Chunghyon/bems_rtu/schematic/RTU_AI_PLATFORM_ESP32_261003.BOM.xlsx

Smart RTU Revised: Friday, October 02, 2026
20260928 Revision: 0.1
 |  |  | 생산대수 |  | 10
Bill Of Materials October 5,2026 3:11:56 | Page1
Item | Quantity | Reference | Part | 규격 | 필요수량 | 비고 | 하나재고번호
______________________________________________
1 | 1 | BD1 | CIM21J601NE/NC | 미삽
2 | 1 | BD2 | CIM21J601NE | 1608,80옴,700mA | 10 | 비드 일반
3 | 1 | B1 | BLM18EG331TN1 | 1608,80옴,700mA | 10 | 비드 일반
4 | 1 | B2 | FB0805/600R/2A | 2012,600옴,0.5A | 10 | Mouser
5 | 2 | CE1,CE3 | 22uF/3216 | 3216 | 20 | Mouser
6 | 3 | CE2,CE5,CE9 | 100uF/10V/6.3mm | SMD전해 6.3pi, 16V | 30 | 랙 커패시터 박스
7 | 2 | CE4,CE8 | 470uF/10V/6.3mm | SMD전해 6.3pi, 16V | 20 | 랙 커패시터 박스
8 | 1 | CE6 | 220uF/50V/8pi | SMD전해 8pi, 16V | 10 | 랙 커패시터 박스
9 | 2 | CE7,CE10 | 470uF/25V | SMD전해 8pi, 16V | 20 | 랙 커패시터 박스
10 | 6 | C1,C5,C8,C10,C11,C13 | 105 | 1608 | 60 | 캡 부품통
11 | 20 | C2,C9,C16,C18,C22,C24, | 104 | 1608 | 200 | 캡 부품통
 |  | C39,C41,C42,C43,C44,C45,
 |  | C46,C54,C66,C72,C80,C81,
 |  | C82,C83
12 | 5 | C3,C17,C65,C71,C77 | 106/2012 | 2012 | 50 | 캡 부품통
13 | 2 | C4,C7 | 106/1608 | 1608 | 20 | 캡 부품통
14 | 3 | C6,C35,C38 | 106 | 1608 | 30 | 캡 부품통
15 | 6 | C14,C15,C50,C52,C61,C73 | 10u | 2012 | 60 | 캡 부품통
16 | 14 | C19,C20,C21,C23,C27,C28, | 103 | 1608 | 140 | 캡 부품통
 |  | C29,C30,C31,C32,C33,C37,
 |  | C68,C75
17 | 4 | C25,C26,C34,C36 | 224 | 1608 | 40 | 캡 부품통
18 | 3 | C40,C49,C64 | 104/100V/2012 | 2012 | 30 | 캡 부품통
19 | 1 | C47 | 1u/50V | 2012 | 10 | 캡 부품통
20 | 2 | C48,C62 | 1n | 1608 | 20 | 캡 부품통
21 | 8 | C51,C53,C57,C59,C70,C74, | 100n | 1608 | 80 | 캡 부품통
 |  | C78,C79
22 | 2 | C55,C56 | 6.8nF | 1608 | 20 | 캡 부품통
23 | 2 | C58,C67 | 18pF | 1608 | 20 | 캡 부품통
24 | 2 | C60,C69 | 104/1608 | 1608 | 20 | 캡 부품통
25 | 1 | C63 | 22n | 1608 | 10 | 캡 부품통
26 | 1 | C76 | 12p | 1608 | 10 | 캡 부품통
27 | 1 | DN1 | PESD2USB5UV-TR |  | 10 | 작업대 위 부품 박스
28 | 16 | D1,D2,D3,D4,D5,D6,D10, | LL4148 |  | 160 | 작업대 아래 SMD 부품통
 |  | D11,D16,D17,D23,D24,D37,
 |  | D38,D39,D41
29 | 1 | D7 | SS16 |  | 10 | Mouser
30 | 1 | D8 | GREEN | 1608 | 10 | 작업대 아래 SMD 부품통
31 | 1 | D9 | RED | 1608 | 10 | 작업대 아래 SMD 부품통
32 | 16 | D12,D13,D14,D15,D18,D19, | GG040205170N2P | 1608 | 160 | mouser
 |  | D20,D21,D22,D25,D26,D27,
 |  | D28,D29,D30,D31
33 | 1 | D32 | BZT52-B15J |  | 10 | Mouser
34 | 1 | D33 | MMSZ5255 | SOT-23-5 | 10 | Mouser
35 | 3 | D34,D35,D36 | B2100A-13-F |  | 30 | Mouser
36 | 12 | F1,F2,F3,F4,F5,F6,F7,F8, | SMDH0805B010TF |  | 120 | mouser
 |  | F9,F10,F11,F12
37 | 2 | IC1,IC2 | ADS131M08 |  | 20 | mouser
38 | 1 | IC3 | 1117-1.8 |  | 10 | 작업대 위 부품 박스
39 | 1 | IC4 | 1117-3.3 |  | 10 | 작업대 위 부품 박스
40 | 1 | J1 | USB_TYPE-C |  | 10 | 작업대 아래 박스
41 | 2 | J2,J5 | ECH350V/6P |  | 20 | 디바이스마트
42 | 3 | J3,J4,J7 | 2.54mm/Header |  | 30 | 작업대 아래 부품 박스
43 | 1 | J6 | 2.54mm |  | 10 | 작업대 아래 부품 박스
44 | 1 | J8 | ECH350V/8P |  | 10 | 디바이스마트
45 | 1 | J9 | SMW250-02 |  | 10 | 디바이스마트
46 | 2 | J11,J12 | ECH350V/2P |  | 20 | 디바이스마트
47 | 1 | J13 | ECH350V/4P |  | 10 | 디바이스마트
48 | 1 | L1 | FCM1608KF-800T07 |  | 10 | 작업대 아래 SMD 부품통
49 | 1 | L2 | NRS4018T2R2 |  | 10 | 작업대 위 부품 박스
50 | 1 | L3 | SLS5D28S330MTT(SWPA6020S3R3MT) | NRS6020T3R3NMGJ | 10 | 디바이스마트
51 | 16 | Q1,Q2,Q3,Q4,Q7,Q8,Q10, | MMBT3904 |  | 160 | Mouser
 |  | Q11,Q12,Q13,Q14,Q15,Q17,
 |  | Q18,Q19,Q21
52 | 2 | Q5,Q6 | BC817-40 |  | 20 | 작업대 위 부품 박스
53 | 1 | Q16 | DMN10H220L-7 |  | 10 | Mouser
54 | 3 | RV1,RV2,RV3 | 391KD07 |  | 30 | Mouser
55 | 16 | R1,R2,R10,R11,R22,R23, | 470 | 1608 | 160 | SMD 부품통
 |  | R86,R87,R106,R110,R123,
 |  | R126,R176,R177,R178,R180
56 | 3 | R3,R52,R62 | 4.7k | 1608 | 30 | SMD 부품통
57 | 12 | R4,R6,R12,R14,R19,R21, | 5k/2012/0.1% |  | 120 | Mouser
 |  | R26,R28,R30,R32,R40,R42
58 | 12 | R5,R7,R13,R15,R20,R24, | 10k/2012/0.1% |  | 120 | Mouser
 |  | R27,R29,R31,R33,R41,R43
59 | 2 | R8,R16 | 5.1k | 1608 | 20 | SMD 부품통
60 | 1 | R9 | 1.5k | 1608 | 10 | SMD 부품통
61 | 16 | R17,R25,R38,R54,R136, | 10k | 1608 | 160 | SMD 부품통
 |  | R143,R144,R145,R147,R150,
 |  | R151,R152,R153,R154,R155,
 |  | R164
62 | 3 | R18,R139,R160 | 1M | 1608 | 30 | SMD 부품통
63 | 18 | R34,R35,R95,R101,R105, | 1k | 1608 | 180 | SMD 부품통
 |  | R111,R116,R118,R120,R125,
 |  | R132,R133,R134,R135,R166,
 |  | R170,R171,R175
64 | 2 | R45,R140 | 10 | 1608 | 20 | SMD 부품통
65 | 6 | R46,R47,R48,R49,R50,R51 | 10/3216 | 3216 | 60 | mouser
66 | 18 | R53,R55,R56,R58,R59,R60, | 100k/3216 | 3216 | 180 | mouser
 |  | R61,R63,R64,R66,R67,R68,
 |  | R69,R70,R71,R73,R74,R75
67 | 3 | R57,R65,R72 | 1k/3216 | 3216 | 30 | mouser
68 | 24 | R76,R77,R78,R79,R80,R81, | 49.9k/2012 | 2012 | 240 | Mouser
 |  | R82,R83,R84,R85,R88,R89,
 |  | R90,R91,R92,R93,R96,R97,
 |  | R102,R103,R108,R109,R112,
 |  | R113
69 | 12 | R94,R98,R100,R107,R114, | 1k/2012 | 2012 | 120 | mouser
 |  | R115,R117,R122,R124,R127,
 |  | R128,R129
70 | 6 | R99,R104,R119,R121,R130, | 49.9/3216 | 3216 | 60 | mouser
 |  | R131
71 | 1 | R137 | 51k | 1608 | 10 | SMD 부품통
72 | 1 | R138 | 24.9k | 1608 | 10 | SMD 부품통
73 | 4 | R141,R142,R158,R159 | 50 | 1608 | 40 | SMD 부품통
74 | 1 | R146 | 100k | 1608 | 10 | SMD 부품통
75 | 1 | R148 | 450k | 1608 | 10 | SMD 부품통
76 | 2 | R149,R157 | 330 | 1608 | 20 | SMD 부품통
77 | 1 | R156 | 5.1 | 1608 | 10 | SMD 부품통
78 | 1 | R161 | 33m/2012 | 2012 | 10 | Mouser
79 | 1 | R162 | 12.4k/1% | 1608 | 10 | SMD 부품통
80 | 1 | R163 | 57k | 1608 | 10 | SMD 부품통
81 | 1 | R165 | 580k | 1608 | 10 | SMD 부품통
82 | 2 | R167,R172 | 150 | 1608 | 20 | SMD 부품통
83 | 2 | R168,R173 | 120 | 1608 | 20 | SMD 부품통
84 | 2 | R169,R174 | 75 | 1608 | 20 | SMD 부품통
85 | 4 | R181,R182,R183,R184 | 750/3216 | 3216 | 40 | Mouser
86 | 2 | R185,R186 | NC | 미삽
87 | 1 | SW1 | SMD TACT |  | 10 | 작업대 위 부품 박스
88 | 1 | SW2 | SW_DIP-6/SM |  | 10 | 디바이스마트
89 | 2 | SW6,SW7 | KDS-03H |  | 20 | 디바이스마트
90 | 4 | S1,S2,S3,S4 | HOLE | 미삽
91 | 6 | U1,U5,U9,U12,U13,U15 | TLV9062/SOIC-8 |  | 60 | mouser
92 | 16 | U2,U3,U7,U8,U10,U11,U20, | IM03GR |  | 160 | 알리익스프레스 봉투
 |  | U21,U22,U23,U24,U25,U36,
 |  | U37,U38,U40
93 | 1 | U4 | PCA9555PWR |  | 10 | 작업대 아래 박스
94 | 1 | U6 | CH340K |  | 10 | 작업대 옆 공구통 위
95 | 1 | U16 | ESPS3-WROOM-1-N16R8 |  | 10 | 알리익스프레스 봉투
96 | 3 | U17,U18,U19 | ZMPT101B | 트랜스, 중국 | 30 | 알리익스프레스 봉투
97 | 2 | U26,U28 | LMB110S |  | 20 | 하나전자
98 | 1 | U27 | AP3417C |  | 10 | 작업대 아래 박스
99 | 1 | U29 | LPJ1153GHNL |  | 10 | 작업대 뒤쪽 부품 박스
100 | 2 | U30,U33 | 78M05-DPAK3 |  | 20 | 작업대 위 부품 박스
101 | 1 | U31 | W5500-QFP48 |  | 10 | 작업대 아래 박스
102 | 1 | U32 | TX4138 |  | 10 | 하나전자
103 | 2 | U34,U35 | MAX485 |  | 20 | 하나전자
104 | 4 | U41,U42,U43,U44 | H11L1 |  | 40 | Mouser
105 | 1 | X1 | 25Mhz(3225_XTAL) | 3225, 30ppm | 10 | Mouser
106 | 1 | Y1 | 8.192Mhz, OSC | 3225, 30ppm | 10 | Mouser
