Chunghyon/bems_rtu/schematic/sch_rtu_261027.pdf

## Activity LED

## I/O Expander

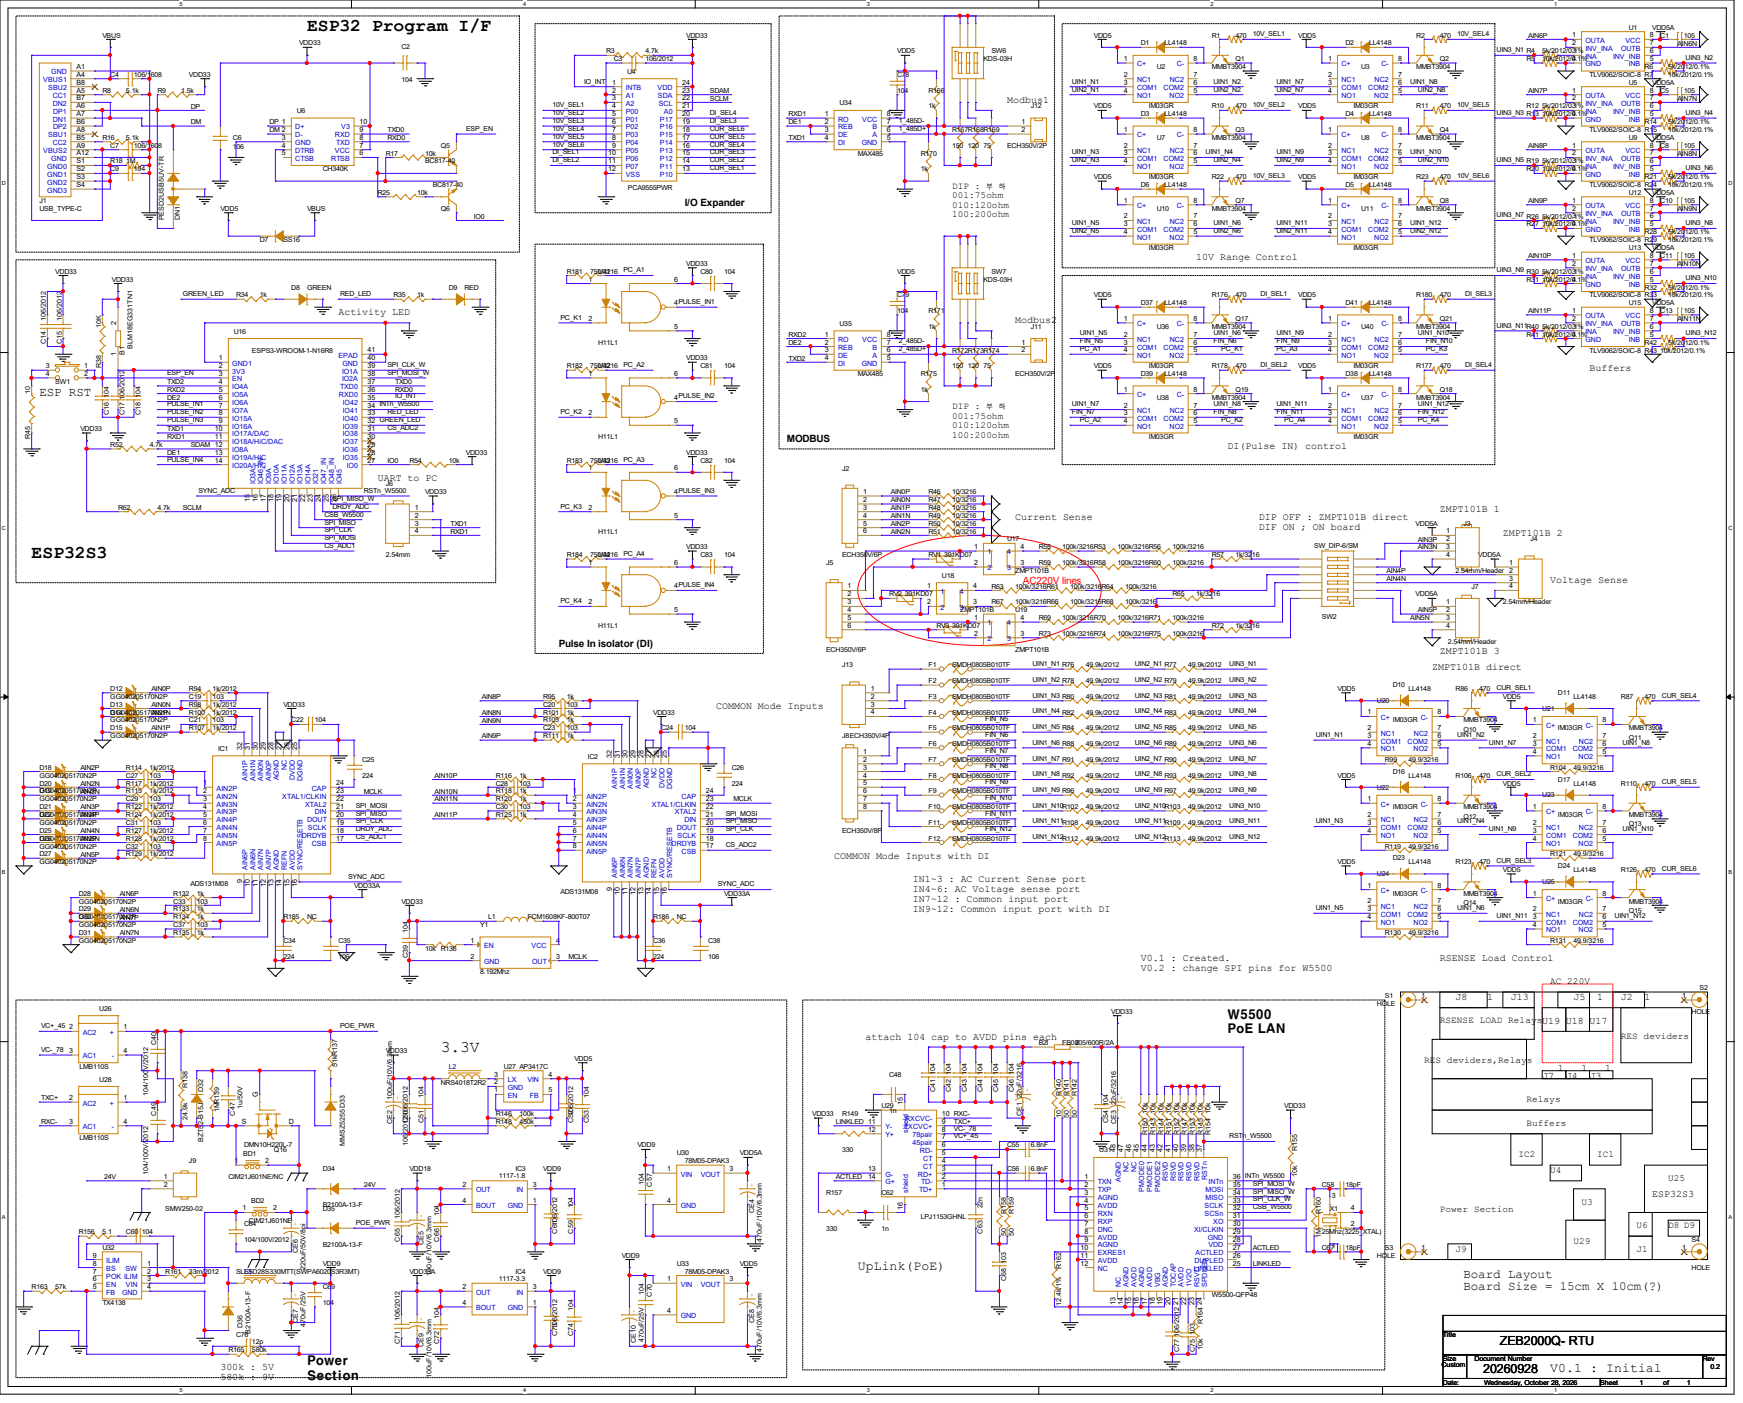
[picture p1: page 1]

U34 MAX485 RO
1 REB
24 DGND ²⁵ DVDD ²⁶ NC ²⁷ AGND ²⁸ AIN⁰P ²⁹ AIN⁰N ³⁰ AIN¹N ³¹ AIN¹P ³² Q5 BC817-40

DI(Pulse IN) control

DIP OFF : ZMPT101B direct
DIF ON ; ON board

Pulse In isolator (DI)

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

9 AIN6N 10 AIN7N 11 AIN7P 12 AGND 13 REFN 14 AVDD 15 SYNC/RESETB 16 CSB DRDYB 17

COMMON Mode Inputs with DI

IN1~3 : AC Current Sense port
IN4~6: AC Voltage sense port
IN7~12 : Common input port
IN9~12: Common input port with DI

V0.1 : Created.
V0.2 : change SPI pins for W5500

VC-_78 VC+_45 RXC- TXC+
