Chunghyon/bems_rtu/(list of files, drawings)

Other design files:
schematic/RTU_AI_PLATFORM_ESP32_261003.DSN
schematic/RTU_AI_PLATFORM_ESP32_261027.DSN
