Chunghyon/bems_rtu/main/eth_w5500.c

#include "project.h"
#include "board.h"
#include "eth_w5500.h"
#include "esp_log.h"
#include "esp_check.h"
#include "esp_mac.h"
#include "driver/gpio.h"
#include "driver/spi_master.h"
#include "esp_rom_sys.h"

#define SPI_ETHERNETS_NUM           1

typedef struct {
    uint8_t spi_cs_gpio;
    int8_t int_gpio;
    uint32_t polling_ms;
    int8_t phy_reset_gpio;
    uint8_t phy_addr;
    uint8_t *mac_addr;
}spi_eth_module_config_t;

static const char *TAG = "w5500_init";

static bool gpio_isr_svc_init_by_eth = false; // indicates that we initialized the GPIO ISR service

// Forward declaration — defined later in this file
static esp_eth_handle_t eth_init_spi(spi_eth_module_config_t *spi_eth_module_config, esp_eth_mac_t **mac_out, esp_eth_phy_t **phy_out);

esp_err_t w5500_reinstall_driver(esp_eth_handle_t *eth_handle_io)
{
    if (!eth_handle_io || !*eth_handle_io) return ESP_ERR_INVALID_ARG;

    esp_eth_handle_t old = *eth_handle_io;
    ESP_LOGI(TAG, "W5500 full driver reinstall requested");

    // Best-effort stop (may fail if state already inconsistent)
    esp_err_t err = esp_eth_stop(old);
    if (err != ESP_OK) {
        ESP_LOGW(TAG, "esp_eth_stop returned %s (continuing with reinstall)", esp_err_to_name(err));
    }
    vTaskDelay(pdMS_TO_TICKS(20));

    esp_eth_mac_t *mac = NULL;
    esp_eth_phy_t *phy = NULL;
    esp_eth_get_mac_instance(old, &mac);
    esp_eth_get_phy_instance(old, &phy);

    err = esp_eth_driver_uninstall(old);
    if (err != ESP_OK) {
        ESP_LOGE(TAG, "driver uninstall failed: %s", esp_err_to_name(err));
        return err;
    }
    if (mac) mac->del(mac);
    if (phy) phy->del(phy);
    *eth_handle_io = NULL;

    // Hardware reset of the chip
    gpio_set_level(ETH_RST_PIN, 0);
    vTaskDelay(pdMS_TO_TICKS(20));
    gpio_set_level(ETH_RST_PIN, 1);
    vTaskDelay(pdMS_TO_TICKS(100));
    ESP_LOGI(TAG, "W5500 RST pin pulsed");

    // Rebuild SPI Ethernet module config and reinstall driver
    spi_eth_module_config_t cfg = { 0 };
    cfg.spi_cs_gpio = ETH_SPI_CS;
    cfg.int_gpio = ETH_INT_PIN;
    cfg.polling_ms = 0;
    cfg.phy_reset_gpio = ETH_RST_PIN;
    cfg.phy_addr = 1;

    uint8_t base_mac[ETH_ADDR_LEN];
    uint8_t local_mac[ETH_ADDR_LEN];
    if (esp_efuse_mac_get_default(base_mac) == ESP_OK) {
        esp_derive_local_mac(local_mac, base_mac);
        cfg.mac_addr = local_mac;
    }

    esp_eth_handle_t neu = eth_init_spi(&cfg, NULL, NULL);
    if (!neu) {
        ESP_LOGE(TAG, "driver reinstall failed");
        return ESP_FAIL;
    }

    *eth_handle_io = neu;
    ESP_LOGI(TAG, "W5500 driver reinstalled");
    return ESP_OK;
}

esp_err_t w5500_hard_reset_and_start(esp_eth_handle_t eth_handle)
{
    if (!eth_handle) return ESP_ERR_INVALID_ARG;

    ESP_LOGI(TAG, "W5500 hardware reset requested");

    esp_err_t err = esp_eth_stop(eth_handle);
    if (err != ESP_OK) {
        ESP_LOGW(TAG, "esp_eth_stop returned %s (continuing)", esp_err_to_name(err));
    }

    vTaskDelay(pdMS_TO_TICKS(20));

    // RST pin pulse (do this even if stop failed — chip needs a known state)
    gpio_set_level(ETH_RST_PIN, 0);
    vTaskDelay(pdMS_TO_TICKS(20));
    gpio_set_level(ETH_RST_PIN, 1);
    vTaskDelay(pdMS_TO_TICKS(150));   // longer settle after hard reset
    ESP_LOGI(TAG, "W5500 RST pin pulsed");

    // Do not touch PHYCFGR — RST bit is active-low (0=reset, 1=normal).
    // Driver will configure auto-negotiation on esp_eth_start().

    err = esp_eth_start(eth_handle);
    if (err != ESP_OK) {
        ESP_LOGE(TAG, "esp_eth_start after hard reset failed: %s", esp_err_to_name(err));
        ESP_LOGE(TAG, "Driver internal state may be inconsistent. Power-cycle recommended.");
        return err;
    }

    ESP_LOGI(TAG, "W5500 hardware reset + re-init done");
    return ESP_OK;
}

static void w5500_hard_reset(void)
{
    gpio_set_level(ETH_RST_PIN, 0);
    vTaskDelay(pdMS_TO_TICKS(10));
    gpio_set_level(ETH_RST_PIN, 1);
    vTaskDelay(pdMS_TO_TICKS(50));
    ESP_LOGI(TAG, "W5500 hard reset done");
}

/**
 * @brief SPI bus initialization (to be used by Ethernet SPI modules)
 *
 * @return
 *          - ESP_OK on success
 */
static esp_err_t spi_bus_init(void)
{
    esp_err_t ret = ESP_OK;

#ifdef ETH_INT_PIN
    gpio_isr_svc_init_by_eth = true;
#endif

#if PP_ETH_USE_SPI3
    // Dedicated SPI3 bus for W5500
    spi_bus_config_t eth_buscfg = {
        .mosi_io_num = ETH_SPI_MOSI,
        .miso_io_num = ETH_SPI_MISO,
        .sclk_io_num = ETH_SPI_CLK,
        .quadwp_io_num = -1,
        .quadhd_io_num = -1,
    };
    ESP_ERROR_CHECK(spi_bus_initialize(ETH_SPI_HOST, &eth_buscfg, SPI_DMA_CH_AUTO));
    ESP_LOGI(TAG, "ETH SPI bus ready (SPI3_HOST, MOSI=%d MISO=%d CLK=%d)",
             ETH_SPI_MOSI, ETH_SPI_MISO, ETH_SPI_CLK);
#else
    ESP_LOGI(TAG, "ETH shares SPI2_HOST with ADCs");
#endif

    return ret;
}

/**
 * @brief Ethernet SPI modules initialization
 *
 * @param[in] spi_eth_module_config specific SPI Ethernet module configuration
 * @param[out] mac_out optionally returns Ethernet MAC object
 * @param[out] phy_out optionally returns Ethernet PHY object
 * @return
 *          - esp_eth_handle_t if init succeeded
 *          - NULL if init failed
 */
static esp_eth_handle_t eth_init_spi(spi_eth_module_config_t *spi_eth_module_config, esp_eth_mac_t **mac_out, esp_eth_phy_t **phy_out)
{
    esp_eth_handle_t ret = NULL;

    // Init common MAC and PHY configs to default
    eth_mac_config_t mac_config = ETH_MAC_DEFAULT_CONFIG();
    eth_phy_config_t phy_config = ETH_PHY_DEFAULT_CONFIG();

    // Update PHY config based on board specific configuration
    phy_config.phy_addr = spi_eth_module_config->phy_addr;
    phy_config.reset_gpio_num = spi_eth_module_config->phy_reset_gpio;

    // Configure SPI interface for specific SPI module
    spi_device_interface_config_t spi_devcfg = {
        .mode = 0,
        .clock_speed_hz = ETH_SPI_CLK_SPEED_HZ,
        .queue_size = 20,
        .spics_io_num = spi_eth_module_config->spi_cs_gpio
    };
    // Init vendor specific MAC config to default, and create new SPI Ethernet MAC instance
    // and new PHY instance based on board configuration
    eth_w5500_config_t w5500_config = ETH_W5500_DEFAULT_CONFIG(ETH_SPI_HOST, &spi_devcfg);
    w5500_config.int_gpio_num = spi_eth_module_config->int_gpio;
    w5500_config.poll_period_ms = spi_eth_module_config->polling_ms;
    esp_eth_mac_t *mac = esp_eth_mac_new_w5500(&w5500_config, &mac_config);
    esp_eth_phy_t *phy = esp_eth_phy_new_w5500(&phy_config);

    // Init Ethernet driver to default and install it
    esp_eth_handle_t eth_handle = NULL;
    esp_eth_config_t eth_config_spi = ETH_DEFAULT_CONFIG(mac, phy);
    ESP_GOTO_ON_FALSE(esp_eth_driver_install(&eth_config_spi, &eth_handle) == ESP_OK, NULL, err, TAG, "SPI Ethernet driver install failed");

    // The SPI Ethernet module might not have a burned factory MAC address, we can set it manually.
    if (spi_eth_module_config->mac_addr != NULL) {
        ESP_GOTO_ON_FALSE(esp_eth_ioctl(eth_handle, ETH_CMD_S_MAC_ADDR, spi_eth_module_config->mac_addr) == ESP_OK,
                                        NULL, err, TAG, "SPI Ethernet MAC address config failed");
    }

    if (mac_out != NULL) {
        *mac_out = mac;
    }
    if (phy_out != NULL) {
        *phy_out = phy;
    }
    return eth_handle;
err:
    if (eth_handle != NULL) {
        esp_eth_driver_uninstall(eth_handle);
    }
    if (mac != NULL) {
        mac->del(mac);
    }
    if (phy != NULL) {
        phy->del(phy);
    }
    return ret;
}

esp_err_t w5500_init(esp_eth_handle_t *eth_handle_out)
{
    w5500_hard_reset();
    
    esp_err_t ret = ESP_OK;
    esp_eth_handle_t eth_handle = NULL;

    ESP_GOTO_ON_FALSE(eth_handle_out != NULL, ESP_ERR_INVALID_ARG, err, TAG, "invalid arguments: initialized handle");

    eth_handle = calloc(SPI_ETHERNETS_NUM, sizeof(esp_eth_handle_t));
    ESP_GOTO_ON_FALSE(eth_handle != NULL, ESP_ERR_NO_MEM, err, TAG, "no memory");

    ESP_GOTO_ON_ERROR(spi_bus_init(), err, TAG, "SPI bus init failed");
    
    // Init specific SPI Ethernet module configuration from Kconfig (CS GPIO, Interrupt GPIO, etc.)
    spi_eth_module_config_t spi_eth_module_config = { 0 };
    spi_eth_module_config.spi_cs_gpio = ETH_SPI_CS;
    spi_eth_module_config.int_gpio = ETH_INT_PIN;
    spi_eth_module_config.polling_ms = 0;
    spi_eth_module_config.phy_reset_gpio = ETH_RST_PIN;
    spi_eth_module_config.phy_addr = 1;
    
    // The SPI Ethernet module(s) might not have a burned factory MAC address, hence use manually configured address(es).
    // In this example, Locally Administered MAC address derived from ESP32x base MAC address is used.
    // Note that Locally Administered OUI range should be used only when testing on a LAN under your control!
    uint8_t base_mac_addr[ETH_ADDR_LEN];
    ESP_GOTO_ON_ERROR(esp_efuse_mac_get_default(base_mac_addr), err, TAG, "get EFUSE MAC failed");
    uint8_t local_mac_1[ETH_ADDR_LEN];
    esp_derive_local_mac(local_mac_1, base_mac_addr);
    spi_eth_module_config.mac_addr = local_mac_1;

    eth_handle = eth_init_spi(&spi_eth_module_config, NULL, NULL);
    ESP_GOTO_ON_FALSE(eth_handle, ESP_FAIL, err, TAG, "SPI Ethernet init failed");

    *eth_handle_out = eth_handle;

    return ret;

err:
    free(eth_handle);
    return ret;

}

esp_err_t w5500_eth_deinit(esp_eth_handle_t *eth_handle)
{
    ESP_RETURN_ON_FALSE(eth_handle != NULL, ESP_ERR_INVALID_ARG, TAG, "Ethernet handle cannot be NULL");

    esp_eth_mac_t *mac = NULL;
    esp_eth_phy_t *phy = NULL;

    if (eth_handle != NULL) {
        esp_eth_get_mac_instance(eth_handle, &mac);
        esp_eth_get_phy_instance(eth_handle, &phy);
        ESP_RETURN_ON_ERROR(esp_eth_driver_uninstall(eth_handle), TAG, "Ethernet %p uninstall failed", eth_handle);
    }

    if (mac != NULL) {
        mac->del(mac);
    }

    if (phy != NULL) {
        phy->del(phy);
    }

#if PP_ETH_USE_SPI3
    spi_bus_free(ETH_SPI_HOST);
#endif

#ifdef ETH_INT_PIN
    // We installed the GPIO ISR service so let's uninstall it too.
    // BE CAREFUL HERE though since the service might be used by other functionality!
    if (gpio_isr_svc_init_by_eth) {
        ESP_LOGW(TAG, "uninstalling GPIO ISR service!");
        gpio_uninstall_isr_service();
    }
#endif

    free(eth_handle);
    return ESP_OK;
}
