Chunghyon/bems_rtu/main/pca9555.c

#include "project.h"
#include "board.h"
#include "pca9555.h"

#include "driver/i2c_master.h"
#include "freertos/FreeRTOS.h"
#include "freertos/task.h"
#include "esp_log.h"

static const char *TAG = "pca9555";

// Address: base 0x20 + (A2<<2 | A1<<1 | A0) = 0x20 + 0x01 = 0x21
#define PCA9555_ADDR            0x21
#define PCA9555_REG_OUTPUT0     0x02
#define PCA9555_REG_OUTPUT1     0x03
#define PCA9555_REG_CONFIG0     0x06
#define PCA9555_REG_CONFIG1     0x07

const char * const pca_port_names[PCA_PORT_COUNT] = {
    "PCA_P0.0 (10V_SEL1)",
    "PCA_P0.1 (10V_SEL2)",
    "PCA_P0.2 (10V_SEL3)",
    "PCA_P0.3 (10V_SEL4)",
    "PCA_P0.4 (10V_SEL5)",
    "PCA_P0.5 (10V_SEL6)",
    "PCA_P0.6 (DI_SEL1)",
    "PCA_P0.7 (DI_SEL2)",
    "PCA_P1.0 (CUR_SEL1)",
    "PCA_P1.1 (CUR_SEL2)",
    "PCA_P1.2 (CUR_SEL3)",
    "PCA_P1.3 (CUR_SEL4)",
    "PCA_P1.4 (CUR_SEL5)",
    "PCA_P1.5 (CUR_SEL6)",
    "PCA_P1.6 (DI_SEL3)",
    "PCA_P1.7 (DI_SEL4)"
};

static i2c_master_bus_handle_t i2c_bus = NULL;
static i2c_master_dev_handle_t pca9555_dev = NULL;

static uint8_t port0_cache = 0;
static uint8_t port1_cache = 0;

static esp_err_t pca9555_write_reg(uint8_t reg, uint8_t val)
{
    if (!pca9555_dev) return ESP_ERR_INVALID_STATE;
    uint8_t buf[2] = {reg, val};
    return i2c_master_transmit(pca9555_dev, buf, 2, pdMS_TO_TICKS(100));
}

static void pca9555_flush_outputs(void)
{
    pca9555_write_reg(PCA9555_REG_OUTPUT0, port0_cache);
    pca9555_write_reg(PCA9555_REG_OUTPUT1, port1_cache);
}

void pca9555_init(void)
{
    i2c_master_bus_config_t bus_cfg = {
        .i2c_port = I2C_NUM_0,
        .sda_io_num = I2C_SDA_PIN,
        .scl_io_num = I2C_SCL_PIN,
        .clk_source = I2C_CLK_SRC_DEFAULT,
        .glitch_ignore_cnt = 7,
        .flags.enable_internal_pullup = true,
    };
    ESP_ERROR_CHECK(i2c_new_master_bus(&bus_cfg, &i2c_bus));

    i2c_device_config_t dev_cfg = {
        .dev_addr_length = I2C_ADDR_BIT_LEN_7,
        .device_address = PCA9555_ADDR,
        .scl_speed_hz = 100000,
    };
    ESP_ERROR_CHECK(i2c_master_bus_add_device(i2c_bus, &dev_cfg, &pca9555_dev));

    // All pins as outputs (0 = output)
    ESP_ERROR_CHECK(pca9555_write_reg(PCA9555_REG_CONFIG0, 0x00));
    ESP_ERROR_CHECK(pca9555_write_reg(PCA9555_REG_CONFIG1, 0x00));

    // All relays off (safe)
    port0_cache = 0;
    port1_cache = 0;
    pca9555_flush_outputs();

    ESP_LOGI(TAG, "PCA9555PWR initialized (addr=0x%02X)", PCA9555_ADDR);
}

void pca9555_deselect_all(void)
{
    port0_cache = 0;
    port1_cache = 0;
    pca9555_flush_outputs();
}

void pca9555_set_pin(pca9555_port_t pin, int level)
{
    if (pin >= PCA_PORT_COUNT) return;
    uint8_t bit = 1u << (pin & 7);
    if (pin < 8) {
        if (level) port0_cache |= bit;
        else       port0_cache &= ~bit;
    } else {
        if (level) port1_cache |= bit;
        else       port1_cache &= ~bit;
    }
    pca9555_flush_outputs();
}

int pca9555_get_pin(pca9555_port_t pin)
{
    if (pin >= PCA_PORT_COUNT) return 0;
    uint8_t bit = 1u << (pin & 7);
    if (pin < 8) return (port0_cache & bit) ? 1 : 0;
    return (port1_cache & bit) ? 1 : 0;
}

// common_idx: 1~6
// term_49r9: 1=use 49.9ohm (CUR_SEL=0), 0=open (CUR_SEL=1)
// r_49k9:    1=49.9k (10V_SEL=0), 0=99.8k (10V_SEL=1)
// use_adc:   for commons 3-6, 1=ADC path, 0=pulse path (ignored for 1-2)
void pca9555_config_common(common_sel_t common_sel, di_sel_t di_sel, cv_sel_t cv_sel, r_sel_t r_sel)
{
    if (common_sel < 1 || common_sel > 6) {
        ESP_LOGW(TAG, "Invalid common_sel=%d (must be 1~6)", common_sel);
        return;
    }

    // DI_SEL only for common 3~6
    if (common_sel >= 3) {
        pca9555_port_t di_port;
        if (common_sel == 3) di_port = PCA_DI_SEL1;
        else if (common_sel == 4) di_port = PCA_DI_SEL2;
        else if (common_sel == 5) di_port = PCA_DI_SEL3;
        else di_port = PCA_DI_SEL4;  // common6

        // 1 = DI/pulse (NO), 0 = ADC path
        pca9555_set_pin(di_port, di_sel);
    }

    pca9555_port_t cur_port = (pca9555_port_t)(PCA_CUR_SEL1 + (common_sel - 1));
    pca9555_port_t v_port   = (pca9555_port_t)(PCA_10V_SEL1 + (common_sel - 1));

    // CUR_SEL: 1 = 49.9ohm (current), 0 = open (voltage)
    pca9555_set_pin(cur_port, (int)cv_sel);
    // 10V_SEL: 1 = 49.9k, 0 = 99.8k
    pca9555_set_pin(v_port, (int)r_sel);

}
