Chunghyon/bems_rtu/(commit log)

2026-10-15 202610151234_Created - Derived from smart_lm_main
    [2ota_full.csv, 2ota_littlefs.csv, RTU_AI_PLATFORM_ESP32_261003.BOM.xlsx, RTU_AI_PLATFORM_ESP32_261003.DSN]
2026-10-16 202610161428 - ADS131M08 설정
2026-10-22 202610221951 1.부팅하면 RESERVED만 자동 보정됩니다. 2.측정 채널을 0점 상태(입력 쇼트 또는 신호 없음)로 만든 뒤 3.시리얼 콘솔에서 c 를 누르면 해당 채널들이 보정됩니다.
2026-10-26 202610261835 - #include "i2c_master.h"
2026-10-26 202610261923 - W5500, Soft/Hart Reset
    [0_main.c, eth_w5500.c, eth_w5500.h]
2026-10-28 202610281629 - Modbus TCP Slave(Server) & UART2 Master
2026-10-28 202610281648 <항목 추가> 피상전력 (kVA) = Vrms × Irms 무효전력 (kVAR) = √(S² − P²) 에너지 적산 (kWh) = ∫ P dt (윈도우마다 누적) 주파수 추정 = 1상 전압 제로크로싱 기반 <Modbus 레지스터 맵 확장> 36-41 Q1/Q2/Q3 (VAR) 42-47 S1/S2/S3 (VA) 48-50 PF1/2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
2026-11-04 202611031445 - Voltage input OK after using Vcm(=AVDD/2) - Current, 1000:1 기준으로 PP_CT_RATIO_10OHM = 100
